HEYAHONG/ExtModule-003/ReadMe.md

# 说明

扩展模块为电路设计的模板，对于基于MCU的模块，主要预定义一些引脚功能，作用与开发板类似。

本扩展模块主要使用芯片:

- [XL2409](https://www.xinlinggo.com/pd.jsp?id=36)

注意:本扩展模块一般不直接使用，一般直接嵌入实际电路设计中

# 数据手册

文件见[Doc](Doc)。

- XL2409 规格书v1.2a.pdf
- XL2400P规格书V1.0a 1.pdf
- XL2400P_Register Map_V1.1.pdf
- APM_PSRAM_E3_QSPI (APS6404L-3SQN KGD_PKG) v2.7.pdf

# 目录结构

- [FW](FW):固件设计，主要为模块MCU固件代码。
- [HW](HW):硬件设计(仅用于参考)。
