HEYAHONG/ExtModule-003/FW/002-base_vm/ReadMe.md

# 说明

本工程作为基础模板，可使用以下方式编译:

- [MDK](MDK-ARM):安装好MDK环境后打开目录下的工程文件即可编译。
- [GCC](GCC)：采用[CMake](https://cmake.org)管理源代码，一般用于各种IDE打开编译。

# 初始化与循环

导出初始化或者循环时,需要设置优先级。

优先级可相同，优先级相同的初始化或者循环的执行顺序由链接顺序决定。

默认情况下，优先级(数字越小，优先级越高)分配如下:

| 优先级范围 | 说明 | 备注 |
| --- | --- | ---- |
| [0,15] | 驱动使用的优先级 | |
| [16,31] | 系统栈（网络栈）使用的优先级  | |
| [32,47] | 用户服务/环境设置使用的优先级 | |
| [48,63] | 应用使用的优先级 | |

# 硬件

## 串口

本工程使用两个串口,分别是串口1与串口2。

其中串口1固定用于控制台(可用于输出日志),串口2用作应用串口。

| 引脚 | 默认功能 | 说明 |
| ---- | --- | --- |
| PA2  | U1TX | 串口1TX |
| PA3  | U1RX | 串口1RX |
| PA4  | U2TX | 串口2TX |
| PA5  | U2RX | 串口2RX |

默认情况下,串口的波特率为115200 8N1。

## LED

默认情况下,本工程定义4个LED(均采用高电平驱动)。

| 引脚 | 默认功能 | 说明 |
| ---- | --- | --- |
| PB0  | NET_LED | 网络状态指示灯 |
| PB1  | SYS_LED | 系统状态指示灯 |
| PA6  | NET_RX_LED | 网络接收指示灯 |
| PA7  | NET_TX_LED | 网络发送成功指示灯 |

## PSRAM

PSRAM提供虚拟机的内存。

默认情况下,采用8M的PSRAM。

### 引脚分配

PSRAM采用SPI接口,PSRAM最大速度33M bps。由于XL2409本身速度不高,故而SPI操作无需延时。

| 引脚 | 默认功能 | 说明 |
| ---- | --- | --- |
| PA15 | PSRAM_CSN  | PSRAM片选 |
| PB3  | PSRAM_SCK  | PSRAM时钟 |
| PB4  | PSRAM_MISO | PSRAM SO  |
| PB5  | PSRAM_MOSI | PSRAM SI  |

# 引脚分配

| 引脚 | 默认功能 | 说明 |
| ---- | --- | --- |
| PA0  | XL2400P_SCK | SIP内部连接，用于与XL2400P通信 |
| PA1  | XL2400P_CSN | SIP内部连接，用于与XL2400P通信 |
| PF1  | XL2400P_SDO | SIP内部连接，用于与XL2400P通信 |
| PF3  | XL2400P_SDI | SIP内部连接，用于与XL2400P通信 |
| PB0  | NET_LED | 网络状态指示灯 |
| PB1  | SYS_LED | 系统状态指示灯 |
| PA6  | NET_RX_LED  | 网络接收指示灯 |
| PA7  | NET_TX_LED  | 网络发送成功指示灯 |
| PA15 | PSRAM_CSN | PSRAM片选 |
| PB3  | PSRAM_SCK | PSRAM时钟 |
| PB4  | PSRAM_MISO  | PSRAM SO |
| PB5  | PSRAM_MOSI  | PSRAM SI |
| PA2  | U1TX | 串口1TX |
| PA3  | U1RX | 串口1RX |
| PA4  | U2TX | 串口2TX |
| PA5  | U2RX | 串口2RX |

# XL2400P

L2400P 系列芯片是工作在 2.400~2.483GHz 世界通用 ISM 频段的单片无线收发芯片。该芯片集成射频收发机、频率收生器、晶体振荡、调制解调器等功能模块，并且支持一对多组网和带 ACK 的通信模式。

## 信道

理论上XL2400P支持2400~2483信道。

RF_CH寄存器也可写入支持的信道值。

注意:在本工程的配置中 **PRX（接收）的信道值=PTX（发送）的信道值-1** ,错误的信道配置可能导致不能正常通信。

## 通道地址

由于通道0可用于增强模式，故而通道0的默认地址仍为芯片默认地址。

通常情况下，如果不使用增强模式，可使用通道0作为广播/任播的接收通道。

通道1~5的默认地址的高32位相同，本工程中将其设置为芯片唯一ID的CRC32校验值，可用于避免默认情况下地址重复。

## 寄存器检测

对于非直接集成在SOC内部的外设而言，时时检测配置寄存器是一个提高健壮性的方法。

对于不使用XL2409直接使用PY32F030x8+XL2400P时，必须检测寄存器防止XL2400P意外复位。

## 增强模式

默认情况下，即使用XL2400P的增强模式,即由XL2400P自动处理重传及应答。

注意:此模式下，**连续传输相同的数据时，除第一个数据包外，后续数据包将被忽略**。因此，一定要在数据包中设计类似序号的字段使得连续的数据包不同。

# 虚拟机

注意:虚拟机必须安装8M PSRAM作为内存。

## 固件

虚拟机可使用兼容mini-rv32ima的固件（暂不兼容Linux），具体见[HCppBox](https://git.hyhsystem.cn/HEYAHONG/HCppBox)的hplatformbox。

默认情况下采用[openblt](https://github.com/feaser/openblt)加载固件，采用xcp_rs232接口(不启用校验和)，硬件连接控制台串口。

## 控制台

虚拟机使用USART1作为控制台,默认参数115200 8N1。可用于固件加载，以及控制台操作。

## 状态指示

状态指示灯可由系统指示灯指示，状态如下:

- 快闪:未初始化
- 熄灭:初始化失败,通常由于PSRAM检测失败。
- 常量:等待加载固件，此时可使用openblt的主机工具加载固件。
- 慢闪:虚拟机固件运行中。
