HEYAHONG/ExtModule-003/HW/SCH_ExtModule-003_2025-06-06.pdf

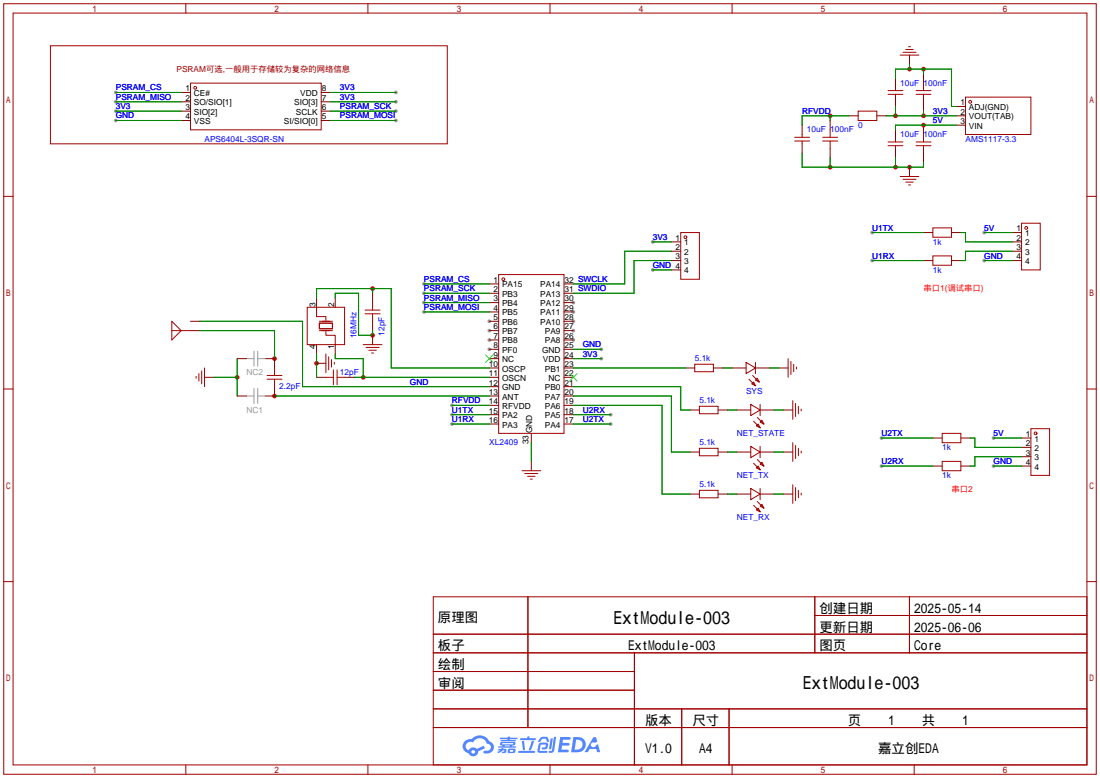
[picture p3: page 1]

原理图 | ExtModule-003 | 创建日期 | 2025-05-14

更新日期 | 2025-06-06

板子 | ExtModule-003 | 图页 | Core
绘制 | | ExtModule-003
审阅

V1.0 | A4 | 嘉立创EDA
