HEYAHONG/ExtModule-003/(list of files, drawings)

Other design files:
HW/ProPrj_ExtModule-003_2025-06-06.epro
