HEYAHONG/ExtModule-003/FW/002-base_vm/main.c

/**
  ******************************************************************************
  * @file    main.c
  * @author  MCU Application Team
  * @brief   Main program body
  ******************************************************************************
  * @attention
  *
  * <h2><center>&copy; Copyright (c) 2023 Puya Semiconductor Co.
  * All rights reserved.</center></h2>
  *
  * This software component is licensed by Puya under BSD 3-Clause license,
  * the "License"; You may not use this file except in compliance with the
  * License. You may obtain a copy of the License at:
  *                        opensource.org/licenses/BSD-3-Clause
  *
  ******************************************************************************
  * @attention
  *
  * <h2><center>&copy; Copyright (c) 2016 STMicroelectronics.
  * All rights reserved.</center></h2>
  *
  * This software component is licensed by ST under BSD 3-Clause license,
  * the "License"; You may not use this file except in compliance with the
  * License. You may obtain a copy of the License at:
  *                        opensource.org/licenses/BSD-3-Clause
  *
  ******************************************************************************
  */

/* Includes ------------------------------------------------------------------*/
#include "main.h"
#include "hbox.h"

/* Private define ------------------------------------------------------------*/
/* Private variables ---------------------------------------------------------*/
/* Private user code ---------------------------------------------------------*/
/* Private macro -------------------------------------------------------------*/
/* Private function prototypes -----------------------------------------------*/
static void APP_SystemClockConfig(void);

/**
  * @brief  Main program.
  * @retval int
  */
int main(void)
{
    /* Reset of all peripherals, Initializes the Systick. */
    HAL_Init();

    /* Configure the system clock */
    APP_SystemClockConfig();

    /*
    * 更新时钟
    */
    SystemCoreClockUpdate();

    /*
     * 重新初始化时钟节拍
     */
    HAL_InitTick(TICK_INT_PRIORITY);

    {
        /*
         * 初始化时间为2020-01-01 00:00:00
         * 主要用于初始化随机数
         */
        hsettimeofday_timeval_t tv= {0};
        tv.tv_sec=1577808000;
        hsettimeofday(&tv,NULL);
    }

    {
        /*
         * 初始化随机数
         */
        HAL_Delay(1);
        uint8_t temp[4]= {0};
        hgetrandom(temp,sizeof(temp),0); //读取一次随机数,进行内部初始化
        srand(hcrc_crc32_fast_calculate((const uint8_t *)UID_BASE,16)); //初始化随机数种子
    }

    //初始化hcpprt
    hcpprt_init();

    while (1)
    {
        //hcpprt循环
        hcpprt_loop();
    }
}

/**
  * @brief  System Clock Configuration
  * @param  None
  * @retval None
  */
static void APP_SystemClockConfig(void)
{
    RCC_OscInitTypeDef RCC_OscInitStruct = {0};
    RCC_ClkInitTypeDef RCC_ClkInitStruct = {0};

    /* Oscillator Configuration */
    RCC_OscInitStruct.OscillatorType = RCC_OSCILLATORTYPE_HSE | RCC_OSCILLATORTYPE_HSI | RCC_OSCILLATORTYPE_LSI | RCC_OSCILLATORTYPE_LSE; /* Select oscillators HSE, HSI, LSI, LSE */
    RCC_OscInitStruct.HSIState = RCC_HSI_ON;                          /* Enable HSI */
    RCC_OscInitStruct.HSIDiv = RCC_HSI_DIV1;                          /* HSI not divided */
    RCC_OscInitStruct.HSICalibrationValue = RCC_HSICALIBRATION_24MHz; /* Configure HSI clock as 24MHz */
    RCC_OscInitStruct.HSEState = RCC_HSE_OFF;                         /* Disable HSE */
    /*RCC_OscInitStruct.HSEFreq = RCC_HSE_16_32MHz;*/
    RCC_OscInitStruct.LSIState = RCC_LSI_ON;                          /* Enable LSI */
    RCC_OscInitStruct.LSEState = RCC_LSE_OFF;                         /* Disable LSE */
    /*RCC_OscInitStruct.LSEDriver = RCC_LSEDRIVE_MEDIUM;*/
    RCC_OscInitStruct.PLL.PLLState = RCC_PLL_ON;                     /* Disable PLL */
    RCC_OscInitStruct.PLL.PLLSource = RCC_PLLSOURCE_HSI;          /* Select HSI as PLL source */
    /* Configure oscillators */
    if (HAL_RCC_OscConfig(&RCC_OscInitStruct) != HAL_OK)
    {
        APP_ErrorHandler();
    }

    /* Clock source configuration */
    RCC_ClkInitStruct.ClockType = RCC_CLOCKTYPE_HCLK | RCC_CLOCKTYPE_SYSCLK | RCC_CLOCKTYPE_PCLK1; /* Select clock types HCLK, SYSCLK, PCLK1 */
    RCC_ClkInitStruct.SYSCLKSource = RCC_SYSCLKSOURCE_PLLCLK; /* Select PLLCLK as the system clock */
    RCC_ClkInitStruct.AHBCLKDivider = RCC_SYSCLK_DIV1;     /* AHB clock not divide */
    RCC_ClkInitStruct.APB1CLKDivider = RCC_HCLK_DIV2;      /* APB clock div2 */
    /* Configure clock source */
    if (HAL_RCC_ClockConfig(&RCC_ClkInitStruct, FLASH_LATENCY_1) != HAL_OK)
    {
        APP_ErrorHandler();
    }
}

/**
  * @brief  This function is executed in case of error occurrence.
  * @param  None
  * @retval None
  */
void APP_ErrorHandler(void)
{
    /* Infinite loop */
    while (1)
    {
    }
}

#ifdef  USE_FULL_ASSERT
/**
  * @brief  Reports the name of the source file and the source line number
  *         where the assert_param error has occurred.
  * @param  file: pointer to the source file name
  * @param  line: assert_param error line source number
  * @retval None
  */
void assert_failed(uint8_t *file, uint32_t line)
{
    /* User can add his own implementation to report the file name and line number,
       for example: printf("Wrong parameters value: file %s on line %d\r\n", file, line)  */
    /* Infinite loop */
    while (1)
    {
    }
}
#endif /* USE_FULL_ASSERT */

/************************ (C) COPYRIGHT Puya *****END OF FILE******************/
