HEYAHONG/ExtModule-003/FW/002-base_vm/drv_softspi_xl2400p.c

#include "main.h"
#include "hbox.h"
#include "drv_led.h"

#ifndef DRV_XL2400P_PRIORITY_LEVEL
#define DRV_XL2400P_PRIORITY_LEVEL    15
#endif

static void xl2400p_reset(void)
{
    //复位
    hsoftspi_xl2400p_write_register(XL2400P_W_REGISTER | XL2400P_CFG_TOP,0x1A);
    while(0xFE != hsoftspi_xl2400p_read_register(XL2400P_R_REGISTER | XL2400P_CFG_TOP))
    {
        HAL_Delay(5);
        hsoftspi_xl2400p_write_register(XL2400P_W_REGISTER | XL2400P_CFG_TOP,0xFE);
    }

    {
        /*
         * 配置模拟
         */
        uint8_t analog_cfg[6]= {0};
        hsoftspi_xl2400p_read_register_buffer(XL2400P_R_REGISTER | XL2400P_ANALOG_CFG3,analog_cfg,sizeof(analog_cfg));
        analog_cfg[5]=((analog_cfg[5]&0xFF) | 0x6D);
        hsoftspi_xl2400p_write_register_buffer(XL2400P_W_REGISTER | XL2400P_ANALOG_CFG3,analog_cfg,sizeof(analog_cfg));
    }

    {
        /*
         * 配置FEATURE
         */
        uint8_t feature=hsoftspi_xl2400p_read_register(XL2400P_R_REGISTER| XL2400P_FEATURE);
        //动态FEC+白化+动态有效长度+动态ACK
        feature |= 0x1D;
        hsoftspi_xl2400p_write_register(XL2400P_W_REGISTER| XL2400P_FEATURE,feature);
    }

    {
        /*
         * 配置ENAA
         */
        uint8_t enaa=hsoftspi_xl2400p_read_register(XL2400P_R_REGISTER| XL2400P_EN_AA);
        enaa |= 0x3F;
        hsoftspi_xl2400p_write_register(XL2400P_W_REGISTER| XL2400P_EN_AA,enaa);
    }
    {
        /*
         * 配置DYNPD
         */
        uint8_t dynpd=hsoftspi_xl2400p_read_register(XL2400P_R_REGISTER| XL2400P_DYNPD);
        dynpd |= 0x3F;
        hsoftspi_xl2400p_write_register(XL2400P_W_REGISTER| XL2400P_DYNPD,dynpd);
    }
    {
        /*
        * 配置PIPE
        */
        uint8_t rxaddr=hsoftspi_xl2400p_read_register(XL2400P_R_REGISTER| XL2400P_EN_RXADDR);
        rxaddr |= 0x3F;
        hsoftspi_xl2400p_write_register(XL2400P_W_REGISTER| XL2400P_EN_RXADDR,rxaddr);
    }
    {
        /*
        * 配置重试次数
        */
        uint8_t retr=hsoftspi_xl2400p_read_register(XL2400P_R_REGISTER| XL2400P_SETUP_RETR);
        retr |= 0x3F;
        hsoftspi_xl2400p_write_register(XL2400P_W_REGISTER| XL2400P_SETUP_RETR,retr);
    }

    {
        /*
        * 配置RF_SETUP
        */
        uint8_t rf_setup[2]= {0x02,0x10};
        hsoftspi_xl2400p_write_register_buffer(XL2400P_W_REGISTER| XL2400P_RF_SETUP,rf_setup,sizeof(rf_setup));
    }

    {
        /*
        * 重新配置CFG_TOP
        */
        uint8_t cfg_top[2]= {0xFE,0x80};
        hsoftspi_xl2400p_write_register_buffer(XL2400P_W_REGISTER| XL2400P_CFG_TOP,cfg_top,sizeof(cfg_top));
    }

}

static void xl2400p_defaults_state()
{
    {
        //发送上电数据帧
        xl2400p_set_channel(XL2400P_DEFAULT_RF_CHANNEL);
        xl2400p_set_is_prx(false);
        xl2400p_set_soft_ce(true);


        HAL_Delay(1);

        //启动发送后停止发送
        xl2400p_set_soft_ce(false);
        HAL_Delay(5);

        //清空缓冲
        xl2400p_flush_rx();
        xl2400p_flush_tx();
        xl2400p_set_rf_status(0x70);
    }
    {
        //接收状态
        xl2400p_set_channel(XL2400P_DEFAULT_RF_CHANNEL-1);
        xl2400p_set_is_prx(true);
        xl2400p_set_soft_ce(true);
    }

}


static xl2400p_loop_event_handler_t xl2400p_loop_event_handler=NULL;
void xl2400p_loop_set_event_handler(xl2400p_loop_event_handler_t evt_handler)
{
    xl2400p_loop_event_handler=evt_handler;
}
static xl2400p_loop_data_handler_t xl2400p_loop_data_handler=NULL;
void xl2400p_loop_set_data_handler(xl2400p_loop_data_handler_t data_handler)
{
    xl2400p_loop_data_handler=data_handler;
}
static void xl2400p_loop(void)
{
    if(xl2400p_get_soft_ce())
    {
        //启用CE后工作
        uint8_t status=xl2400p_get_rf_status();
        if(xl2400p_get_is_prx())
        {
            //接收模式
            if((status&(1<< XL2400P_LOOP_EVENT_RX_DS))!=0)
            {
                //有数据进入FIFO
                led_trigger_net_rx();
                uint8_t px=((status >> 1)&0x7); //PIPE编号
                uint8_t datalen=xl2400p_read_rx_fifo_length();
                if((hsoftspi_xl2400p_read_register(XL2400P_R_REGISTER| XL2400P_FEATURE)&(1 << 5))!=0)
                {
                    //128字节包
                    uint8_t data[128]= {0};
                    xl2400p_read_rx_fifo(data,datalen);
                    if(xl2400p_loop_data_handler!=NULL)
                    {
                        xl2400p_loop_data_handler(data,datalen,px);
                    }
                }
                else
                {
                    //32字节包
                    uint8_t data[32]= {0};
                    xl2400p_read_rx_fifo(data,datalen);
                    if(xl2400p_loop_data_handler!=NULL)
                    {
                        xl2400p_loop_data_handler(data,datalen,px);
                    }
                }
                if(xl2400p_loop_event_handler!=NULL)
                {
                    xl2400p_loop_event_handler(XL2400P_LOOP_EVENT_RX_DS);
                }
            }
        }
        else
        {
            //发送模式
            if(((status&(1<< XL2400P_LOOP_EVENT_TX_DS))!=0))
            {
                //发送完成
                led_trigger_net_tx();
                if(xl2400p_loop_event_handler!=NULL)
                {
                    xl2400p_loop_event_handler(XL2400P_LOOP_EVENT_TX_DS);
                }
            }

            if(((status&(1<< XL2400P_LOOP_EVENT_MAX_RT))!=0))
            {
                //超过最大重试次数
                if(xl2400p_loop_event_handler!=NULL)
                {
                    xl2400p_loop_event_handler(XL2400P_LOOP_EVENT_MAX_RT);
                }
                else
                {
                    /*
                     * 如果不清空tx_fifo,芯片将一直重试发送,当用户处理此事件时需要注意重复进入的问题。
                     */
                    xl2400p_flush_tx();
                }
            }
        }

        //清除相应的状态位
        xl2400p_set_rf_status(status);
    }
}

#define CSN_Low()                       HAL_GPIO_WritePin(GPIOA, GPIO_PIN_1, GPIO_PIN_RESET);
#define CSN_High()                      HAL_GPIO_WritePin(GPIOA, GPIO_PIN_1, GPIO_PIN_SET);

#define SCK_High()                      HAL_GPIO_WritePin(GPIOA, GPIO_PIN_0, GPIO_PIN_SET);
#define SCK_Low()                       HAL_GPIO_WritePin(GPIOA, GPIO_PIN_0, GPIO_PIN_RESET);

#define SPI_MOSI_High()                 HAL_GPIO_WritePin(GPIOF, GPIO_PIN_3, GPIO_PIN_SET);
#define SPI_MOSI_Low()                  HAL_GPIO_WritePin(GPIOF, GPIO_PIN_3, GPIO_PIN_RESET);

#define Read_SPI_MISO()                 HAL_GPIO_ReadPin(GPIOF,GPIO_PIN_1)

static void hsoftspi_xl2400p_lowlevel_init()
{
    /*使能模块时钟*/
    __HAL_RCC_GPIOF_CLK_ENABLE();//PF
    __HAL_RCC_GPIOA_CLK_ENABLE();//PA

    GPIO_InitTypeDef   GPIO_InitStruct;

    GPIO_InitStruct.Pin   = GPIO_PIN_1;
    GPIO_InitStruct.Mode  = GPIO_MODE_INPUT;
    GPIO_InitStruct.Pull  = GPIO_PULLUP;
    GPIO_InitStruct.Speed = GPIO_SPEED_FREQ_HIGH;

    HAL_GPIO_Init(GPIOF, &GPIO_InitStruct);

    GPIO_InitStruct.Pin   = GPIO_PIN_3;
    GPIO_InitStruct.Mode  = GPIO_MODE_OUTPUT_PP;
    GPIO_InitStruct.Pull  = GPIO_NOPULL;
    GPIO_InitStruct.Speed = GPIO_SPEED_FREQ_HIGH;

    HAL_GPIO_Init(GPIOF, &GPIO_InitStruct);

    GPIO_InitStruct.Pin   = GPIO_PIN_0|GPIO_PIN_1;
    GPIO_InitStruct.Mode  = GPIO_MODE_OUTPUT_PP;
    GPIO_InitStruct.Pull  = GPIO_NOPULL;
    GPIO_InitStruct.Speed = GPIO_SPEED_FREQ_HIGH;

    HAL_GPIO_Init(GPIOA, &GPIO_InitStruct);

    CSN_High();
    SCK_Low();


    xl2400p_reset();
}



#ifdef HRUNTIME_USING_INIT_SECTION
void  hsoftspi_xl2400p_init(const hruntime_function_t *func)
{
    hsoftspi_xl2400p_lowlevel_init();

    xl2400p_defaults_state();
}
HRUNTIME_INIT_EXPORT(softspi_xl2400p,DRV_XL2400P_PRIORITY_LEVEL,hsoftspi_xl2400p_init,NULL);
#endif
#ifdef HRUNTIME_USING_LOOP_SECTION
void  hsoftspi_xl2400p_loop(const hruntime_function_t *func)
{
    //XL2400P循环
    xl2400p_loop();
}
HRUNTIME_LOOP_EXPORT(softspi_xl2400p,DRV_XL2400P_PRIORITY_LEVEL,hsoftspi_xl2400p_loop,NULL);
#endif

static void hsoftspi_xl2400p_write_byte(uint8_t buff)
{
    uint8_t i = 0;

    for(i = 0; i < 8; i++)
    {
        SCK_Low();

        if(buff & 0x80)
        {
            SPI_MOSI_High();
        }
        else
        {
            SPI_MOSI_Low();
        }

        buff = buff << 1;

        SCK_High();
    }
    SPI_MOSI_High();
    SCK_Low();
}


static uint8_t hsoftspi_xl2400p_read_byte(void)
{

    uint8_t  buff = 0;
    uint8_t  i = 0;

    for(i = 0; i < 8; i++)
    {
        SCK_Low();
        buff = buff << 1;
        SCK_High();
        if(Read_SPI_MISO())
        {
            buff |= 0x01;
        }
    }
    SCK_Low();

    return buff;
}


void hsoftspi_xl2400p_write_register(uint8_t RF_Reg,uint8_t W_Data)
{
    CSN_Low();//拉低片选
    hsoftspi_xl2400p_write_byte(RF_Reg);//写入地址
    hsoftspi_xl2400p_write_byte(W_Data);//写入数据
    CSN_High();//写入完成拉高片选
}


uint8_t hsoftspi_xl2400p_read_register(uint8_t RF_Reg)
{
    uint8_t rTemp =0;
    CSN_Low();
    hsoftspi_xl2400p_write_byte(RF_Reg);//写入地址+读取指令
    rTemp = hsoftspi_xl2400p_read_byte();//读取数据
    CSN_High();
    return rTemp;
}


void hsoftspi_xl2400p_write_register_buffer(uint8_t RF_Reg, uint8_t *pBuff, uint8_t Len)
{
    uint8_t rTemp = 0;
    uint8_t i = 0;
    CSN_Low();
    hsoftspi_xl2400p_write_byte(RF_Reg);
    for(i = 0 ; i < Len ; i++)
    {
        rTemp = pBuff[i];
        hsoftspi_xl2400p_write_byte(rTemp);
    }
    CSN_High();
}


void hsoftspi_xl2400p_read_register_buffer(uint8_t RF_Reg, uint8_t *pBuff, uint8_t Len)
{
    uint8_t i=0;
    CSN_Low();
    hsoftspi_xl2400p_write_byte(RF_Reg);
    for(i = 0 ; i < Len ; i++)
    {
        pBuff[i] = hsoftspi_xl2400p_read_byte();
    }
    CSN_High();
}

void xl2400p_reset_chip(void)
{
    xl2400p_reset();
}

void xl2400p_set_channel(uint16_t channel)
{
    if(channel < 2400)
    {
        channel = 2400;
    }
    if(channel > 2483)
    {
        channel = 2483;
    }
    uint8_t enaa=hsoftspi_xl2400p_read_register(XL2400P_R_REGISTER| XL2400P_EN_AA);
    enaa &= (~(0x40));
    hsoftspi_xl2400p_write_register(XL2400P_W_REGISTER| XL2400P_EN_AA,enaa);
    uint8_t buffer[2]= {0};
    buffer[0]=(uint8_t)channel;
    buffer[1]=(uint8_t)(channel >> 8);
    hsoftspi_xl2400p_write_register_buffer(XL2400P_W_REGISTER+XL2400P_RF_CH,buffer,sizeof(buffer));
    enaa |= (0x40);
    hsoftspi_xl2400p_write_register(XL2400P_W_REGISTER| XL2400P_EN_AA,enaa);
}

bool xl2400p_get_soft_ce(void)
{
    uint8_t cfg_top=hsoftspi_xl2400p_read_register(XL2400P_R_REGISTER+XL2400P_CFG_TOP);
    return (cfg_top&0x01)!=0;
}

void xl2400p_set_soft_ce(bool ce_enable)
{
    uint8_t cfg_top=hsoftspi_xl2400p_read_register(XL2400P_R_REGISTER+XL2400P_CFG_TOP);
    if(ce_enable)
    {
        cfg_top|=0x01;
    }
    else
    {
        cfg_top&=(~0x01);
    }
    hsoftspi_xl2400p_write_register(XL2400P_W_REGISTER+XL2400P_CFG_TOP,cfg_top);
}

bool xl2400p_get_is_prx(void)
{
    uint8_t cfg_top[2]= {0};
    hsoftspi_xl2400p_read_register_buffer(XL2400P_R_REGISTER+XL2400P_CFG_TOP,cfg_top,sizeof(cfg_top));
    return (cfg_top[1]&(1<<6))!=0;
}

void xl2400p_set_is_prx(bool prx_mode)
{
    uint8_t cfg_top[2]= {0};
    hsoftspi_xl2400p_read_register_buffer(XL2400P_R_REGISTER+XL2400P_CFG_TOP,cfg_top,sizeof(cfg_top));
    if(prx_mode)
    {
        cfg_top[1]|= (1<<6);
    }
    else
    {
        cfg_top[1]&= (~(1<<6));
    }
    hsoftspi_xl2400p_write_register_buffer(XL2400P_W_REGISTER+XL2400P_CFG_TOP,cfg_top,sizeof(cfg_top));
}

uint8_t xl2400p_get_rf_status(void)
{
    return hsoftspi_xl2400p_read_register(XL2400P_R_REGISTER+XL2400P_RF_STATUS);
}

void xl2400p_set_rf_status(uint8_t rf_status)
{
    hsoftspi_xl2400p_write_register(XL2400P_W_REGISTER+XL2400P_RF_STATUS,rf_status);
}

uint32_t xl2400p_get_rf_fifo_status(void)
{
    uint8_t fifo_status[4]= {0};
    hsoftspi_xl2400p_read_register_buffer(XL2400P_R_REGISTER+XL2400P_STATUS_FIFO,fifo_status,sizeof(fifo_status));
    return fifo_status[0]*(1UL << 0) + fifo_status[1]*(1UL << 8) + fifo_status[2]*(1UL << 16) + fifo_status[3]*(1UL << 24);
}

void xl2400p_flush_tx(void)
{
    hsoftspi_xl2400p_write_register(XL2400P_FLUSH_TX,XL2400P_CMD_NOP);
}

void xl2400p_flush_rx(void)
{
    hsoftspi_xl2400p_write_register(XL2400P_FLUSH_RX,XL2400P_CMD_NOP);
}

void xl2400p_set_tx_addr(const void *addr,size_t addr_len)
{
    if(addr!=NULL)
    {
        if(addr_len > 5)
        {
            addr_len=5;
        }
        hsoftspi_xl2400p_write_register_buffer(XL2400P_W_REGISTER| XL2400P_TX_ADDR,(uint8_t *)addr,addr_len);
    }
}

void xl2400p_get_tx_addr(void *addr,size_t addr_len)
{
    if(addr!=NULL)
    {
        if(addr_len > 5)
        {
            addr_len=5;
        }
        hsoftspi_xl2400p_read_register_buffer(XL2400P_R_REGISTER| XL2400P_TX_ADDR,(uint8_t *)addr,addr_len);
    }
}

void xl2400p_set_rx_addr0(const void *addr,size_t addr_len)
{
    if(addr!=NULL)
    {
        if(addr_len > 5)
        {
            addr_len=5;
        }
        hsoftspi_xl2400p_write_register_buffer(XL2400P_W_REGISTER| XL2400P_RX_ADDR_P0,(uint8_t *)addr,addr_len);
    }
}

void xl2400p_get_rx_addr0(void *addr,size_t addr_len)
{
    if(addr!=NULL)
    {
        if(addr_len > 5)
        {
            addr_len=5;
        }
        hsoftspi_xl2400p_read_register_buffer(XL2400P_R_REGISTER| XL2400P_RX_ADDR_P0,(uint8_t *)addr,addr_len);
    }
}

void xl2400p_set_rx_addr1(const void *addr,size_t addr_len)
{
    if(addr!=NULL)
    {
        if(addr_len > 5)
        {
            addr_len=5;
        }
        hsoftspi_xl2400p_write_register_buffer(XL2400P_W_REGISTER| XL2400P_RX_ADDR_P1,(uint8_t *)addr,addr_len);
    }
}

void xl2400p_get_rx_addr1(void *addr,size_t addr_len)
{
    if(addr!=NULL)
    {
        if(addr_len > 5)
        {
            addr_len=5;
        }
        hsoftspi_xl2400p_read_register_buffer(XL2400P_R_REGISTER| XL2400P_RX_ADDR_P1,(uint8_t *)addr,addr_len);
    }
}

void xl2400p_set_rx_addr2top5(const void *addr,size_t addr_len)
{
    if(addr!=NULL)
    {
        if(addr_len > 4)
        {
            addr_len=4;
        }
        hsoftspi_xl2400p_write_register_buffer(XL2400P_W_REGISTER| XL2400P_RX_ADDR_P2TOP5,(uint8_t *)addr,addr_len);
    }
}

void xl2400p_get_rx_addr2top5(void *addr,size_t addr_len)
{
    if(addr!=NULL)
    {
        if(addr_len > 4)
        {
            addr_len=4;
        }
        hsoftspi_xl2400p_read_register_buffer(XL2400P_R_REGISTER| XL2400P_RX_ADDR_P2TOP5,(uint8_t *)addr,addr_len);
    }
}

void xl2400p_get_rx_addr(uint8_t px,void *addr,size_t addr_len)
{
    if(addr!=NULL && addr_len!=0)
    {
        switch(px)
        {
        case 0:
        {
            xl2400p_get_rx_addr0(addr,addr_len);
        }
        break;
        case 1:
        {
            xl2400p_get_rx_addr1(addr,addr_len);
        }
        break;
        case 2:
        case 3:
        case 4:
        case 5:
        {
            xl2400p_get_rx_addr1(addr,addr_len);
            uint8_t p2top5[4]= {0};
            xl2400p_get_rx_addr2top5(p2top5,sizeof(p2top5));
            ((uint8_t *)addr)[0]=p2top5[px-2];
        }
        break;
        default:
            break;
        }
    }
}

void xl2400p_set_rx_addr(uint8_t px,const void *addr,size_t addr_len)
{
    if(addr!=NULL && addr_len!=0)
    {
        switch(px)
        {
        case 0:
        {
            xl2400p_set_rx_addr0(addr,addr_len);
        }
        break;
        case 1:
        {
            xl2400p_set_rx_addr1(addr,addr_len);
        }
        break;
        case 2:
        case 3:
        case 4:
        case 5:
        {
            /*
            * 通道2~通道5只能设置最低字节地址
            */
            uint8_t p2top5[4]= {0};
            xl2400p_get_rx_addr2top5(p2top5,sizeof(p2top5));
            p2top5[px-2]=((uint8_t *)addr)[0];
            xl2400p_set_rx_addr2top5(p2top5,sizeof(p2top5));
        }
        break;
        default:
            break;
        }
    }
}

uint8_t xl2400p_get_rx_payload_length(uint8_t px)
{
    uint8_t rx_pw[6]= {0};
    if(px >= 5)
    {
        px=5;
    }
    hsoftspi_xl2400p_read_register_buffer(XL2400P_R_REGISTER| XL2400P_RX_PW_PX,rx_pw,sizeof(rx_pw));
    return rx_pw[px];
}

void xl2400p_set_rx_payload_length(uint8_t px,uint8_t pipe_width)
{
    uint8_t rx_pw[6]= {0};
    if(px >= 5)
    {
        px=5;
    }
    hsoftspi_xl2400p_read_register_buffer(XL2400P_R_REGISTER| XL2400P_RX_PW_PX,rx_pw,sizeof(rx_pw));
    rx_pw[px]=pipe_width;
    hsoftspi_xl2400p_write_register_buffer(XL2400P_W_REGISTER| XL2400P_RX_PW_PX,rx_pw,sizeof(rx_pw));
}

int8_t xl2400p_get_rx_pipe_num(void)
{
    int8_t ret=-1;
    uint8_t status=xl2400p_get_rf_status();
    if((status & (1<<6))!=0)
    {
        ret=((status >> 1)&0x07);
    }
    return ret;
}

void xl2400p_write_tx_fifo(const void *data,size_t data_len)
{
    if(data!=NULL && data_len > 0)
    {
        hsoftspi_xl2400p_write_register_buffer(XL2400P_W_TX_PLOAD,(uint8_t *)data,data_len);
    }
}

void xl2400p_write_tx_fifo_noack(const void *data,size_t data_len)
{
    if(data!=NULL && data_len > 0)
    {
        hsoftspi_xl2400p_write_register_buffer(XL2400P_W_TX_PLOAD_NOACK,(uint8_t *)data,data_len);
    }
}

void xl2400p_read_rx_fifo(void *data,size_t data_len)
{
    if(data!=NULL && data_len > 0)
    {
        hsoftspi_xl2400p_read_register_buffer(XL2400P_R_RX_PLOAD,(uint8_t *)data,data_len);
    }
}

uint8_t xl2400p_read_rx_fifo_length(void)
{
    return hsoftspi_xl2400p_read_register(XL2400P_R_RX_PL_WID);
}
