HEYAHONG/ExtModule-003/FW/001-base/service_wireless.c

#include "service_wireless.h"
#include "drv_softspi_xl2400p.h"

#ifndef SERVICE_WIRELESS_PRIORITY_LEVEL
#define SERVICE_WIRELESS_PRIORITY_LEVEL    31
#endif

/*
 * 发送时的序号
 */
static uint16_t wireless_frame_seq=0;
static struct
{
    uint32_t tx_busy:1;
} wireless_state;
static service_wireless_frame_boardcast_rx_handler_t service_wireless_frame_boardcast_rx_handler=NULL;
static uint8_t service_wireless_frame_boardcast_ringbuffer[512];
static hringbuf_t *service_wireless_frame_boardcast_ringbuffer_get(void)
{
    hringbuf_t * buffer=hringbuf_get((uint8_t *)service_wireless_frame_boardcast_ringbuffer,sizeof(service_wireless_frame_boardcast_ringbuffer));
    hringbuf_set_lock(buffer,NULL,NULL,NULL);
    return buffer;
}

void xl2400p_loop_event_handler(xl2400p_loop_event_t evt)
{
    {
        //打印事件
        switch(evt)
        {
        case XL2400P_LOOP_EVENT_RX_DS:
        {
            console_printf("wireless: event RX_DS");
        }
        break;
        case XL2400P_LOOP_EVENT_TX_DS:
        {
            wireless_frame_seq++;
            wireless_state.tx_busy=0;
            console_printf("wireless: event TX_DS");
        }
        break;
        case XL2400P_LOOP_EVENT_MAX_RT:
        {
            wireless_frame_seq++;
            wireless_state.tx_busy=0;
            console_printf("wireless: event MAX_RT");
        }
        break;
        default:
        {
            console_printf("wireless: event UNKOWN");
        }
        break;
        }
    }
}

void xl2400p_loop_data_handler(uint8_t *data,size_t datalen,uint8_t px)
{
    if(data==NULL || datalen==0)
    {
        return;
    }
    switch(px)
    {
    case 0: /* 通道0,公共通道 */
    {
        {
            uint8_t public_addr[5]= {0};
            product_config_public_channel_addr(public_addr,sizeof(public_addr));
            uint8_t pipe_addr[sizeof(public_addr)]= {0};
            xl2400p_get_rx_addr(px,pipe_addr,sizeof(pipe_addr));
            if(memcmp(public_addr,pipe_addr,sizeof(pipe_addr))!=0)
            {
                //不是公共通道地址，可能是正在发送其它通道的数据将通道0作为了ACK接收通道。
                break;
            }
        }
        service_wireless_frame_header_t header= {0};
        memcpy(&header,data,sizeof(header));
        if(datalen==32 && header.flag.byte==0 && header.crc8==0 && header.seq==0)
        {
            /*
             * 处理上电数据帧
             */
            uint32_t packet_header=0;
            memcpy(&packet_header,data,sizeof(packet_header));
            if(packet_header==0 && memcmp(&data[sizeof(packet_header)],product_config_product_id_get(NULL),16)==0)
            {
                /*
                * 处理上电数据帧(解密加密部分)
                */
                product_config_data_chacha20_crypto(&data[20],12,packet_header,NULL,0);
                char buffer[64+1]= {0};
                hbase16_encode_with_null_terminator(buffer,sizeof(buffer),data,datalen);
                if(strcmp("hello",(const char *)&data[20])==0)
                {
                    /*
                     * 默认的hello数据帧
                     */
                    console_printf("wireless: powerup frame addr=%s",&buffer[26*2]);
                }
            }
        }
        else if((header.flag.byte!=0 || header.crc8!=0 || header.seq!=0) && datalen > sizeof(header))
        {
            /*
             * 处理广播的其它数据
             */
            if(header.flag.b_crypt!=0)
            {
                //公共通道解密
                uint32_t packet_header=0;
                memcpy(&packet_header,data,sizeof(packet_header));
                product_config_data_chacha20_crypto(&data[sizeof(header)],datalen-sizeof(header),packet_header,NULL,0);
            }
            uint8_t buffer[128]= {0};
            size_t  buffer_len=datalen-sizeof(header);
            if(header.flag.b_compress!=0)
            {
                //对数据进行解压缩
                buffer_len=product_config_data_uncompress(buffer,sizeof(buffer),&data[sizeof(header)],buffer_len);
            }
            else
            {
                //直接复制
                memcpy(buffer,&data[sizeof(header)],buffer_len);
            }
            if(buffer_len == 0)
            {
                //解压缩出错
                break;
            }
            if(!hcrc_crc8_fast_check(buffer,buffer_len,header.crc8))
            {
                //CRC8校验错误
                break;
            }
            if(service_wireless_frame_boardcast_rx_handler!=NULL)
            {
                service_wireless_frame_boardcast_rx_handler(buffer,buffer_len);
            }
            console_printf("wireless:boardcast frame!");
        }
    }
    break;
    default:
    {

    }
    break;
    }
}

size_t  service_wireless_frame_boardcast_generate(service_wireless_frame_t *frame,uint8_t * data,size_t datalen)
{
    size_t ret=0;
    if(frame==NULL || data == NULL || datalen ==0 || datalen > sizeof(frame->data))
    {
        return ret;
    }
    memset(frame,0,sizeof(service_wireless_frame_t));
    frame->header.flag.px=0;         //广播时通道必须设置为0
    frame->header.flag.type=0;       //广播时类型设置为0
    frame->header.crc8=hcrc_crc8_fast_calculate(data,datalen);
    frame->header.flag.b_compress=((0!=(ret=product_config_data_try_compress(frame->data,sizeof(frame->data),data,datalen)))?1:0);
    if(ret==0)
    {
        ret=datalen;
    }
    frame->header.seq=wireless_frame_seq;
    //默认都进行加密
    frame->header.flag.b_crypt=1;
    if(frame->header.flag.b_crypt!=0)
    {
        //进行公共通道的加密
        uint32_t packet_header=0;
        memcpy(&packet_header,&frame->header,sizeof(packet_header));
        product_config_data_chacha20_crypto(frame->data,ret,packet_header,NULL,0);
    }
    return ret+sizeof(frame->header);
};

void service_wireless_frame_boardcast_set_rx_handler(service_wireless_frame_boardcast_rx_handler_t _rx_handler)
{
    service_wireless_frame_boardcast_rx_handler=_rx_handler;
}

size_t service_wireless_frame_boardcast_transmit(uint8_t *data,size_t datalen)
{
    return hringbuf_input(service_wireless_frame_boardcast_ringbuffer_get(),data,datalen);
}

#ifdef HRUNTIME_USING_INIT_SECTION
static void  hwireless_init(const hruntime_function_t *func)
{
    xl2400p_loop_set_event_handler(xl2400p_loop_event_handler);
    xl2400p_loop_set_data_handler(xl2400p_loop_data_handler);
    console_printf("service_wireless init!");
    //console_printf("wireless:sizeof(service_wireless_frame_header_t)=%d,sizeof(service_wireless_frame_t)=%d",(int)sizeof(service_wireless_frame_header_t),(int)sizeof(service_wireless_frame_t));
    hgetrandom(&wireless_frame_seq,sizeof(wireless_frame_seq),0);
    console_printf("wireless:wireless_frame_seq=%d",(int)wireless_frame_seq);
}
HRUNTIME_INIT_EXPORT(wireless,SERVICE_WIRELESS_PRIORITY_LEVEL,hwireless_init,NULL);
#endif
#ifdef HRUNTIME_USING_LOOP_SECTION
static void  hwireless_boardcast_tx(void)
{
    size_t len=hringbuf_get_length(service_wireless_frame_boardcast_ringbuffer_get());
    service_wireless_frame_t frame= {0};
    if(len > sizeof(frame.data))
    {
        len=sizeof(frame.data);
    }
    uint8_t buffer[sizeof(frame.data)]= {0};
    hringbuf_output(service_wireless_frame_boardcast_ringbuffer_get(),buffer,len);
    wireless_state.tx_busy=1;
    xl2400p_write_tx_fifo_noack(&frame,service_wireless_frame_boardcast_generate(&frame,buffer,len));
}
static hdefaults_tick_t last_loop_tick=0;
static void  hwireless_loop(const hruntime_function_t *func)
{
    if(xl2400p_get_is_prx())
    {
        last_loop_tick=hdefaults_tick_get();
        if(hringbuf_get_length(service_wireless_frame_boardcast_ringbuffer_get()) > 0)
        {
            xl2400p_set_soft_ce(false);
            HAL_Delay(1);
            xl2400p_flush_rx();
            xl2400p_flush_tx();
            xl2400p_set_rf_status(0x70);
            uint8_t address[5]= {0};
            product_config_public_channel_addr(address,sizeof(address));
            xl2400p_set_tx_addr(address,sizeof(address));
            xl2400p_set_rx_addr0(address,sizeof(address));
            xl2400p_set_channel(XL2400P_DEFAULT_RF_CHANNEL);
            xl2400p_set_is_prx(false);
            xl2400p_set_soft_ce(true);

            //发送数据
            hwireless_boardcast_tx();

        }
    }
    else
    {
        if(wireless_state.tx_busy==0)
        {
            last_loop_tick=hdefaults_tick_get();
            if(hringbuf_get_length(service_wireless_frame_boardcast_ringbuffer_get()) > 0)
            {
                xl2400p_flush_rx();
                xl2400p_flush_tx();
                xl2400p_set_rf_status(0x70);
                uint8_t address[5]= {0};
                product_config_public_channel_addr(address,sizeof(address));
                xl2400p_set_tx_addr(address,sizeof(address));
                xl2400p_set_rx_addr0(address,sizeof(address));
                xl2400p_set_channel(XL2400P_DEFAULT_RF_CHANNEL);
                xl2400p_set_is_prx(false);
                xl2400p_set_soft_ce(true);

                //发送数据
                hwireless_boardcast_tx();
            }
            else
            {
                xl2400p_set_soft_ce(false);
                HAL_Delay(1);
                xl2400p_flush_rx();
                xl2400p_flush_tx();
                xl2400p_set_rf_status(0x70);
                uint8_t address[5]= {0};
                product_config_public_channel_addr(address,sizeof(address));
                xl2400p_set_tx_addr(address,sizeof(address));
                xl2400p_set_rx_addr0(address,sizeof(address));
                xl2400p_set_channel(XL2400P_DEFAULT_RF_CHANNEL-1);
                xl2400p_set_is_prx(true);
                xl2400p_set_soft_ce(true);
            }

        }
        else
        {

            if(hdefaults_tick_get()-last_loop_tick > 75)
            {
                /*
                 * 单次发送超时
                 */
                xl2400p_set_soft_ce(false);
                HAL_Delay(1);
                xl2400p_flush_rx();
                xl2400p_flush_tx();
                xl2400p_set_rf_status(0x70);
                uint8_t address[5]= {0};
                product_config_public_channel_addr(address,sizeof(address));
                xl2400p_set_tx_addr(address,sizeof(address));
                xl2400p_set_rx_addr0(address,sizeof(address));
                xl2400p_set_channel(XL2400P_DEFAULT_RF_CHANNEL-1);
                xl2400p_set_is_prx(true);
                xl2400p_set_soft_ce(true);
                wireless_state.tx_busy=0;
            }
        }
    }
}
HRUNTIME_LOOP_EXPORT(wireless,SERVICE_WIRELESS_PRIORITY_LEVEL,hwireless_loop,NULL);
#endif
