HEYAHONG/ExtModule-003/FW/002-base_vm/drv_softspi_xl2400p.h

#ifndef __DRV_SOFTSPI_XL2400P_H__
#define __DRV_SOFTSPI_XL2400P_H__
#include "stdint.h"
#include "stdbool.h"
#include "stdlib.h"

#ifdef __cplusplus
extern "C"
{
#endif // __cplusplus


void hsoftspi_xl2400p_write_register(uint8_t RF_Reg,uint8_t W_Data);
uint8_t hsoftspi_xl2400p_read_register(uint8_t RF_Reg);
void hsoftspi_xl2400p_write_register_buffer(uint8_t RF_Reg, uint8_t *pBuff, uint8_t Len);
void hsoftspi_xl2400p_read_register_buffer(uint8_t RF_Reg, uint8_t *pBuff, uint8_t Len);


typedef enum
{
    XL2400P_LOOP_EVENT_RX_DS=6,
    XL2400P_LOOP_EVENT_TX_DS=5,
    XL2400P_LOOP_EVENT_MAX_RT=4,
} xl2400p_loop_event_t;

typedef void (*xl2400p_loop_event_handler_t)(xl2400p_loop_event_t evt);
void xl2400p_loop_set_event_handler(xl2400p_loop_event_handler_t evt_handler);

typedef void (*xl2400p_loop_data_handler_t)(uint8_t *data,size_t datalen,uint8_t px);
void xl2400p_loop_set_data_handler(xl2400p_loop_data_handler_t data_handler);

/*********************************************************************/
/************************* 寄存器地址定义 *****************************/
/*********************************************************************/

#define XL2400P_CFG_TOP                         (0X00)
#define XL2400P_EN_AA                           (0X01)
#define XL2400P_EN_RXADDR                       (0X02)
#define XL2400P_SETUP_AW                        (0X03)
#define XL2400P_SETUP_RETR                      (0X04)
#define XL2400P_RF_CH                           (0X05)
#define XL2400P_RF_SETUP                        (0X06)
#define XL2400P_RF_STATUS                       (0X07)
#define XL2400P_OBSERVE_TX                      (0X08)
#define XL2400P_RSSI                            (0X09)
#define XL2400P_RX_ADDR_P0                      (0X0A)
#define XL2400P_RX_ADDR_P1                      (0X0B)
#define XL2400P_RX_ADDR_P2                      (0X2)        //存储在RX_ADDR_P2TOP5
#define XL2400P_RX_ADDR_P3                      (0X3)        //存储在RX_ADDR_P2TOP5
#define XL2400P_RX_ADDR_P4                      (0X4)        //存储在RX_ADDR_P2TOP5
#define XL2400P_RX_ADDR_P5                      (0X5)        //存储在RX_ADDR_P2TOP5
#define XL2400P_RX_ADDR_P2TOP5                  (0X0C)
#define XL2400P_BER_RESULT                      (0X0D)
#define XL2400P_AGC_SETTING                     (0X0E)
#define XL2400P_PGA_SETTING                     (0X0F)
#define XL2400P_TX_ADDR                         (0X10)
#define XL2400P_RX_PW_PX                        (0X11)
#define XL2400P_ANALOG_CFG0                     (0X12)
#define XL2400P_ANALOG_CFG1                     (0X13)
#define XL2400P_ANALOG_CFG2                     (0X14)
#define XL2400P_ANALOG_CFG3                     (0X15)
#define XL2400P_STATUS_FIFO                     (0X17)
#define XL2400P_RSSIREC                         (0X18)
#define XL2400P_TXPROC_CFG                      (0X19)
#define XL2400P_RXPROC_CFG                      (0X1A)
#define XL2400P_DYNPD                           (0X1C)
#define XL2400P_FEATURE                         (0X1D)
#define XL2400P_RAMP_CFG                        (0X1E)

/*********************************************************************/
/*************************** 操作指令定义 *****************************/
/*********************************************************************/

#define XL2400P_R_REGISTER                      0x00 //读寄存器指令                                     
#define XL2400P_W_REGISTER                      0x20 //写寄存器指令
#define XL2400P_R_RX_PLOAD                      0x61 //读接收数据指令
#define XL2400P_W_TX_PLOAD                      0xA0 //写发射数据指令
#define XL2400P_FLUSH_TX                        0xE1 //清空TX-FIFO指令   
#define XL2400P_FLUSH_RX                        0xE2 //清空RX-FIFO指令 
#define XL2400P_R_RX_PL_WID                     0x60 //读RX-FIFO数据长度指令
#define XL2400P_W_ACK_PLOAD                     0xA8
#define XL2400P_W_TX_PLOAD_NOACK                0xB0
#define XL2400P_CMD_NOP                         0xFF //空操作

#define XL2400P_DEFAULT_RF_CHANNEL                          2417

/*
 * 复位
 */
void xl2400p_reset_chip(void);

/*
 * 设置通道频率
 */
void xl2400p_set_channel(uint16_t channel);

/*
 * 获取CE
 */
bool xl2400p_get_soft_ce(void);

/*
 * 设置CE
 */
void xl2400p_set_soft_ce(bool ce_enable);

/*
 * 获取是否是PRX模式
 */
bool xl2400p_get_is_prx(void);

/*
 * 设置是否是PRX模式
 */
void xl2400p_set_is_prx(bool prx_mode);


/*
 * 读取RF状态
 */
uint8_t xl2400p_get_rf_status(void);

/*
 * 写入RF状态(某些状态位可通过写1清0)
 */
void xl2400p_set_rf_status(uint8_t rf_status);

/*
 * 读取RF_FIFO状态
 */
uint32_t xl2400p_get_rf_fifo_status(void);


/*
 * 清空发送
 */
void xl2400p_flush_tx(void);

/*
 * 清空接收
 */
void xl2400p_flush_rx(void);

/*
 * 设置发送地址
 */
void xl2400p_set_tx_addr(const void *addr,size_t addr_len);

/*
* 读取发送地址
 */
void xl2400p_get_tx_addr(void *addr,size_t addr_len);

/*
 * 设置接收地址(通道0)
 */
void xl2400p_set_rx_addr0(const void *addr,size_t addr_len);

/*
 * 读取接收地址(通道0)
 */
void xl2400p_get_rx_addr0(void *addr,size_t addr_len);

/*
 * 设置接收地址(通道1)
 */
void xl2400p_set_rx_addr1(const void *addr,size_t addr_len);

/*
 * 读取接收地址(通道1)
 */
void xl2400p_get_rx_addr1(void *addr,size_t addr_len);


/*
 * 设置接收地址(通道2到5)
 */
void xl2400p_set_rx_addr2top5(const void *addr,size_t addr_len);

/*
 * 读取接收地址(通道2到5)
 */
void xl2400p_get_rx_addr2top5(void *addr,size_t addr_len);

/*
 * 获取接收地址(0~5)
 */
void xl2400p_get_rx_addr(uint8_t px,void *addr,size_t addr_len);

/*
 * 设置接收地址(0~5)
 */
void xl2400p_set_rx_addr(uint8_t px,const void *addr,size_t addr_len);

/*
 * 读取PIPE负载数据长度设置
 */
uint8_t xl2400p_get_rx_payload_length(uint8_t px);

/*
 * 写入PIPE负载数据长度设置
 */
void xl2400p_set_rx_payload_length(uint8_t px,uint8_t pipe_width);

/*
 * 获取待接收的通道(-1表示出错)
 */
int8_t xl2400p_get_rx_pipe_num(void);

/*
 * 写TX FIFO
 */
void xl2400p_write_tx_fifo(const void *data,size_t data_len);


/*
 * 写TX FIFO(无ACK),注意:需要使能相应功能后生效
 */
void xl2400p_write_tx_fifo_noack(const void *data,size_t data_len);

/*
 * 读取RX FIFO
 */
void xl2400p_read_rx_fifo(void *data,size_t data_len);

/*
 * 读取RX FIFO中的数据长度
 */
uint8_t xl2400p_read_rx_fifo_length(void);

#ifdef __cplusplus
}
#endif // __cplusplus

#endif
