HEYAHONG/ExtModule-003/FW/002-base_vm/app_main.h

#ifndef __APP_MAIN_H__
#define __APP_MAIN_H__
#include "main.h"
#include "hbox.h"
#include "product_config.h"
#ifdef __cplusplus
extern "C"
{
#endif // __cplusplus


#ifdef __cplusplus
}
#endif // __cplusplus

#endif
