HEYAHONG/ExtModule-003/FW/001-base/product_config.h

#ifndef __PRODUCT_CONFIG_H__
#define __PRODUCT_CONFIG_H__
#include "stdbool.h"
#include "stdint.h"
#include "stdlib.h"
#include "string.h"
#include "main.h"
#include "hbox.h"
#ifdef __cplusplus
extern "C"
{
#endif // __cplusplus

/*
 * 产品名称
 */
#ifdef  PRODUCT_NAME
#define PRODUCT_NAME ExtModule_003
#endif

/*
 * 产品密码
 */
#ifdef  PRODUCT_PSK
#define PRODUCT_NAME ExtModule_003_PSK
#endif

/*
 * 产品启用xl2400p寄存器检查
 */
#ifndef PRODUCT_XL2400P_REGISTER_CHECK_ENABLE
#define PRODUCT_XL2400P_REGISTER_CHECK_ENABLE 0
#endif

/*
 * 产品启用console(0=不使能,1=使能)
 */
#ifndef PRODUCT_CONSOLE_ENABLE
#define PRODUCT_CONSOLE_ENABLE 1
#endif

/*
 * 产品启用SHELL(0=不使能,1=使能)
 */
#ifndef PRODUCT_SHELL_ENABLE
#define PRODUCT_SHELL_ENABLE 0
#endif

/*
 * 产品启用UART2广播数据包透传(可用于测试)
 */
#ifndef PRODUCT_UART2_BOARDCAST
#define PRODUCT_UART2_BOARDCAST 1
#endif

/*
 * 获取产品ID(通过产品名称计算得来),通常128位。
 * 可用于区分不同的网络。
 */
const uint8_t * product_config_product_id_get(size_t *product_id_len);

/*
 * 获取产品密钥(通过产品ID与),通常256位。
 * 可用于通信过程中使用AES或者ChaCha20加密的密钥。
 */
const uint8_t * product_config_product_key_get(size_t *product_key_len);

/*
 * 获取产品公共地址(广播地址).公共地址后4字节为产品ID的CRC32,其余字节填充0xFF
 */
bool product_config_public_channel_addr(uint8_t *addr,size_t addr_len);


/*
 * 获取产品私有地址，私有地址后4字节为UID（唯一ID）的CRC32，其余字节填充0x00(可用于分配子地址，不能修改为0xFF).
 */
bool product_config_private_channel_addr(uint8_t *addr,size_t addr_len,const uint8_t *uid,size_t uid_len);

/*
 * Chacha20加密/解密。内部采用
 *     counter 计数器初值,一般使用帧中的序号决定
 *     nonce(nonce_len) 一次性数字，一般由建立连接时双方协商(最高96位),默认情况下使用公共地址填充未使用的字节。
 */
bool product_config_data_chacha20_crypto(uint8_t *data,size_t data_len,uint32_t counter,const uint8_t *nonce,size_t nonce_len);

/*
 * 数据压缩，返回压缩后的大小(0表示失败)
 * 当数据中有大量的重复数据时，推荐通过压缩减少重复数据(也可减少加密通信时密钥流泄露的风险)。注意:使用压缩时需确保至少剩余1.5KB的栈空间
 */
size_t product_config_data_compress(void *dst,size_t dst_len,const void *src,size_t src_len);


/*
 * 数据尝试压缩，当压缩失败时或者压缩后大小大于原大小时，复制源数据到目标缓冲区
 * 要求同product_config_data_compress
 */
size_t product_config_data_try_compress(void *dst,size_t dst_len,const void *src,size_t src_len);


/*
 * 数据解压缩，返回解压缩后的大小(0表示失败)
 */
size_t product_config_data_uncompress(void *dst,size_t dst_len,const void *src,size_t src_len);



#ifdef __cplusplus
}
#endif // __cplusplus

#endif
