HEYAHONG/ExtModule-003/FW/001-base/drv_product.c

#include "product_config.h"
#include "hbox.h"

#ifndef DRV_PRODUCT_PRIORITY_LEVEL
#define DRV_PRODUCT_PRIORITY_LEVEL    4
#endif

#ifdef HRUNTIME_USING_INIT_SECTION
static void  hproduct_init(const hruntime_function_t *func)
{
    //在此处进行计算可减少栈溢出的可能性。
    product_config_product_id_get(NULL);
    product_config_product_key_get(NULL);
}
HRUNTIME_INIT_EXPORT(product,DRV_PRODUCT_PRIORITY_LEVEL,hproduct_init,NULL);
#endif
#ifdef HRUNTIME_USING_LOOP_SECTION
static void  hproduct_loop(const hruntime_function_t *func)
{

}
HRUNTIME_LOOP_EXPORT(product,DRV_PRODUCT_PRIORITY_LEVEL,hproduct_loop,NULL);
#endif
