HEYAHONG/ExtModule-003/(commit log)

2025-05-29 添加PY32F030x8开发环境
2025-05-29 启用HBox的hruntime的初始化段与循环段
2025-05-29 移除多余的代码
2025-05-30 添加XL2400P软SPI驱动
2025-05-30 调大栈(为复杂算法做准备)
2025-05-30 添加数据手册
2025-05-30 更新说明
2025-05-30 添加说明
2025-05-30 启用独立看门狗
2025-05-31 添加寄存器检测
2025-05-31 优化寄存器检查
2025-05-31 修复寄存器校验BUG
2025-05-31 寄存器的某些位需要复位完成且处于上电模式才能写入
2025-06-01 完善产品信息
2025-06-01 将产品ID格式化为UUID
2025-06-05 更新HCppBox，优化编译时间
2025-06-06 更新HCppBox
2025-06-07 添加参考硬件设计
    [ProPrj_ExtModule-003_2025-06-06.epro]
2025-06-13 完善产品配置
2025-06-13 修复BUG
2025-06-16 完善常用操作
2025-06-16 完善XL2400P循环
2025-06-16 完善XL2400P初始化
2025-06-17 完善初始化设置
2025-06-17 完善发送地址设置
2025-06-17 添加XL2400P默认状态代码
2025-06-17 完善发送失败时处理
2025-06-17 完善说明
2025-06-17 优化XL2400P接口
2025-06-17 完善接口
2025-06-18 添加压缩函数
2025-06-18 完善XL2400P接口
2025-06-18 启用LTO减小体积
2025-06-19 添加上电数据帧
2025-06-20 初始化随机数
2025-06-20 初步设计无线协议栈
2025-06-20 修复启用FORBID_VECT_TAB_MIGRATION带来的问题
2025-06-24 初步添加LED驱动
2025-06-24 关闭半主机模式，防止程序因断点而不能运行
2025-06-24 完善LED说明
2025-06-24 限制网络指示灯触发时间
2025-06-25 添加PSRAM说明
2025-06-25 完善PSRAM说明
2025-06-25 初步添加PSRAM驱动
2025-06-26 初步添加串口驱动
2025-06-26 串口采用中断接收
2025-06-26 串口采用轮询发送
2025-06-27 使用优先级调整驱动初始化顺序
2025-06-27 添加控制台服务
2025-06-27 将XL2400P寄存器检查功能设置为可选功能
2025-06-27 关闭部分printf功能以节省空间
2025-06-27 显示上电数据帧内容
2025-06-27 完善注释
2025-06-30 完善无线协议栈
2025-07-01 添加透传应用
2025-07-01 添加单次发送超时失败后恢复接收状态
2025-07-03 更新HCppBox,初始化软件虚拟内存
2025-10-27 修复时钟错误
2026-06-30 [HCppBox] 更新源代码
2026-07-19 [001-base] 修复汇编标志问题
2026-09-06 [FW] 更新HCppBox
2026-09-10 [FW] 初步添加002-base_vm
2026-09-10 [FW] 更新说明
2026-09-11 [002-base_vm] 优化代码
2026-09-11 [002-base_vm] 更新说明
2026-11-02 [.github] 添加工作流文件
2026-11-02 [FW] 更新MDK工程文件
